LasanthaSudeera/AI-Agent-Traffic-ESP8266/freecad-case/Case.FCStd

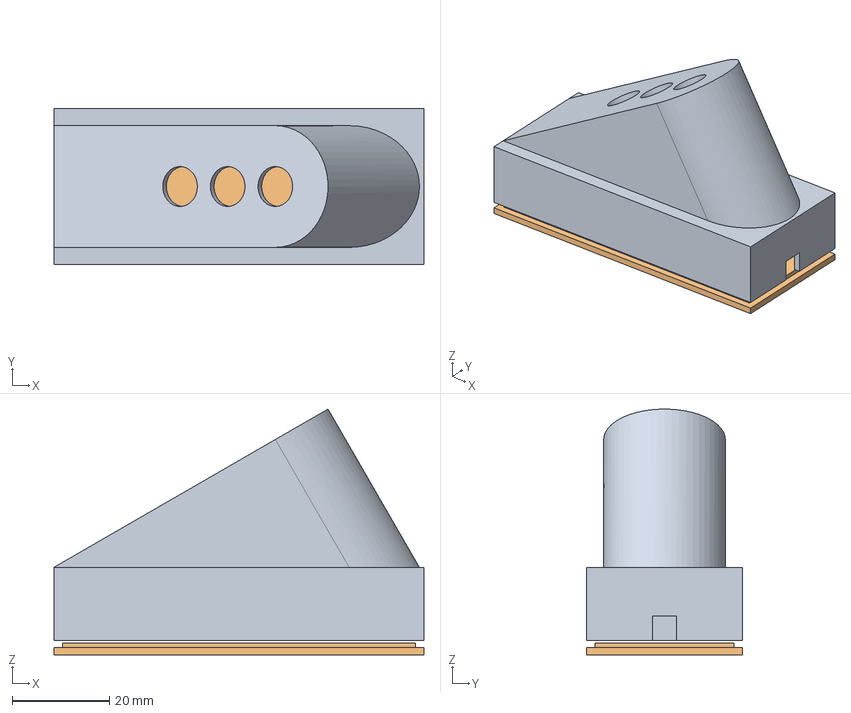
[picture p1: CAD file, 2026-09-17]
freecad-case/Case.FCStd
76.0 x 32.0 x 50.5 mm
