LasanthaSudeera/AI-Agent-Traffic-ESP8266/freecad-case/Case-Body.stl

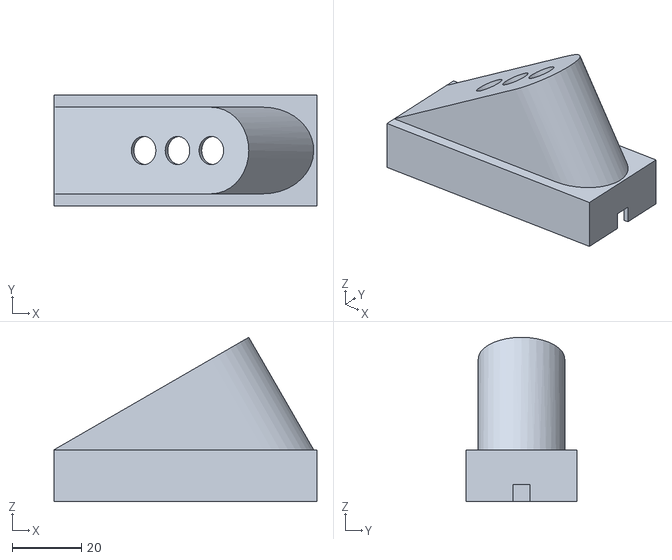
[picture p2: CAD file, 2026-09-17]
freecad-case/Case-Body.stl
76.0 x 32.0 x 47.5
