LasanthaSudeera/AI-Agent-Traffic-ESP8266/freecad-case/Case-Cover.stl

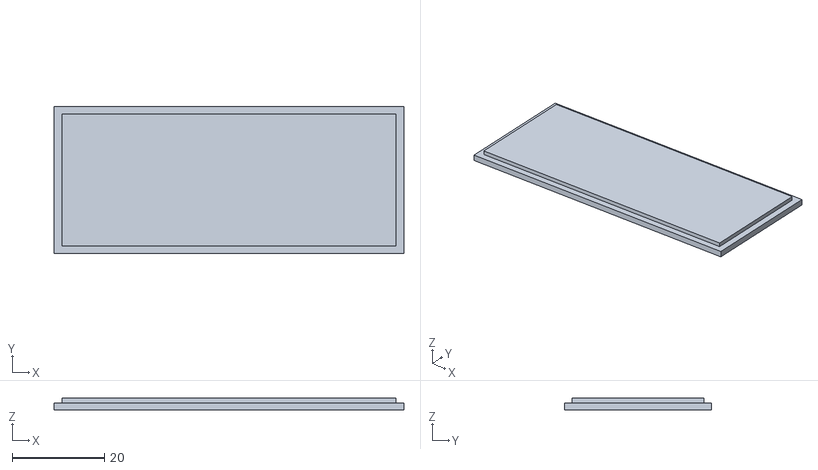
[picture p3: CAD file, 2026-09-17]
freecad-case/Case-Cover.stl
76.0 x 32.0 x 2.50
