LasanthaSudeera/AI-Agent-Traffic-ESP8266/(commit log)

2026-09-15 fix: enforce strict status request validation
    [ai-agent-indicator.ino]
2026-09-15 sample claude hook
2026-09-17 freecad case design
    [Case-Body.stl, Case-Cover.stl, Case.FCStd]
2026-09-17 docs: identify gcode target printer
2026-09-19 build: pin ESP8266 firmware dependencies
2026-09-19 feat: persist provisioning device name
2026-09-19 fix: preserve device settings on write failure
    [DeviceSettings.cpp]
2026-09-19 fix: harden Wi-Fi provisioning recovery
    [DeviceSettings.cpp, ProvisioningPolicy.cpp, ProvisioningPolicy.h, WifiProvisioning.cpp, WifiProvisioning.h]
